lukeovalle/tdse-tpf_1-01/invernadero/invernadero.kicad_pcb

## KiCad design invernadero/invernadero.kicad_pcb (2026-03-22)

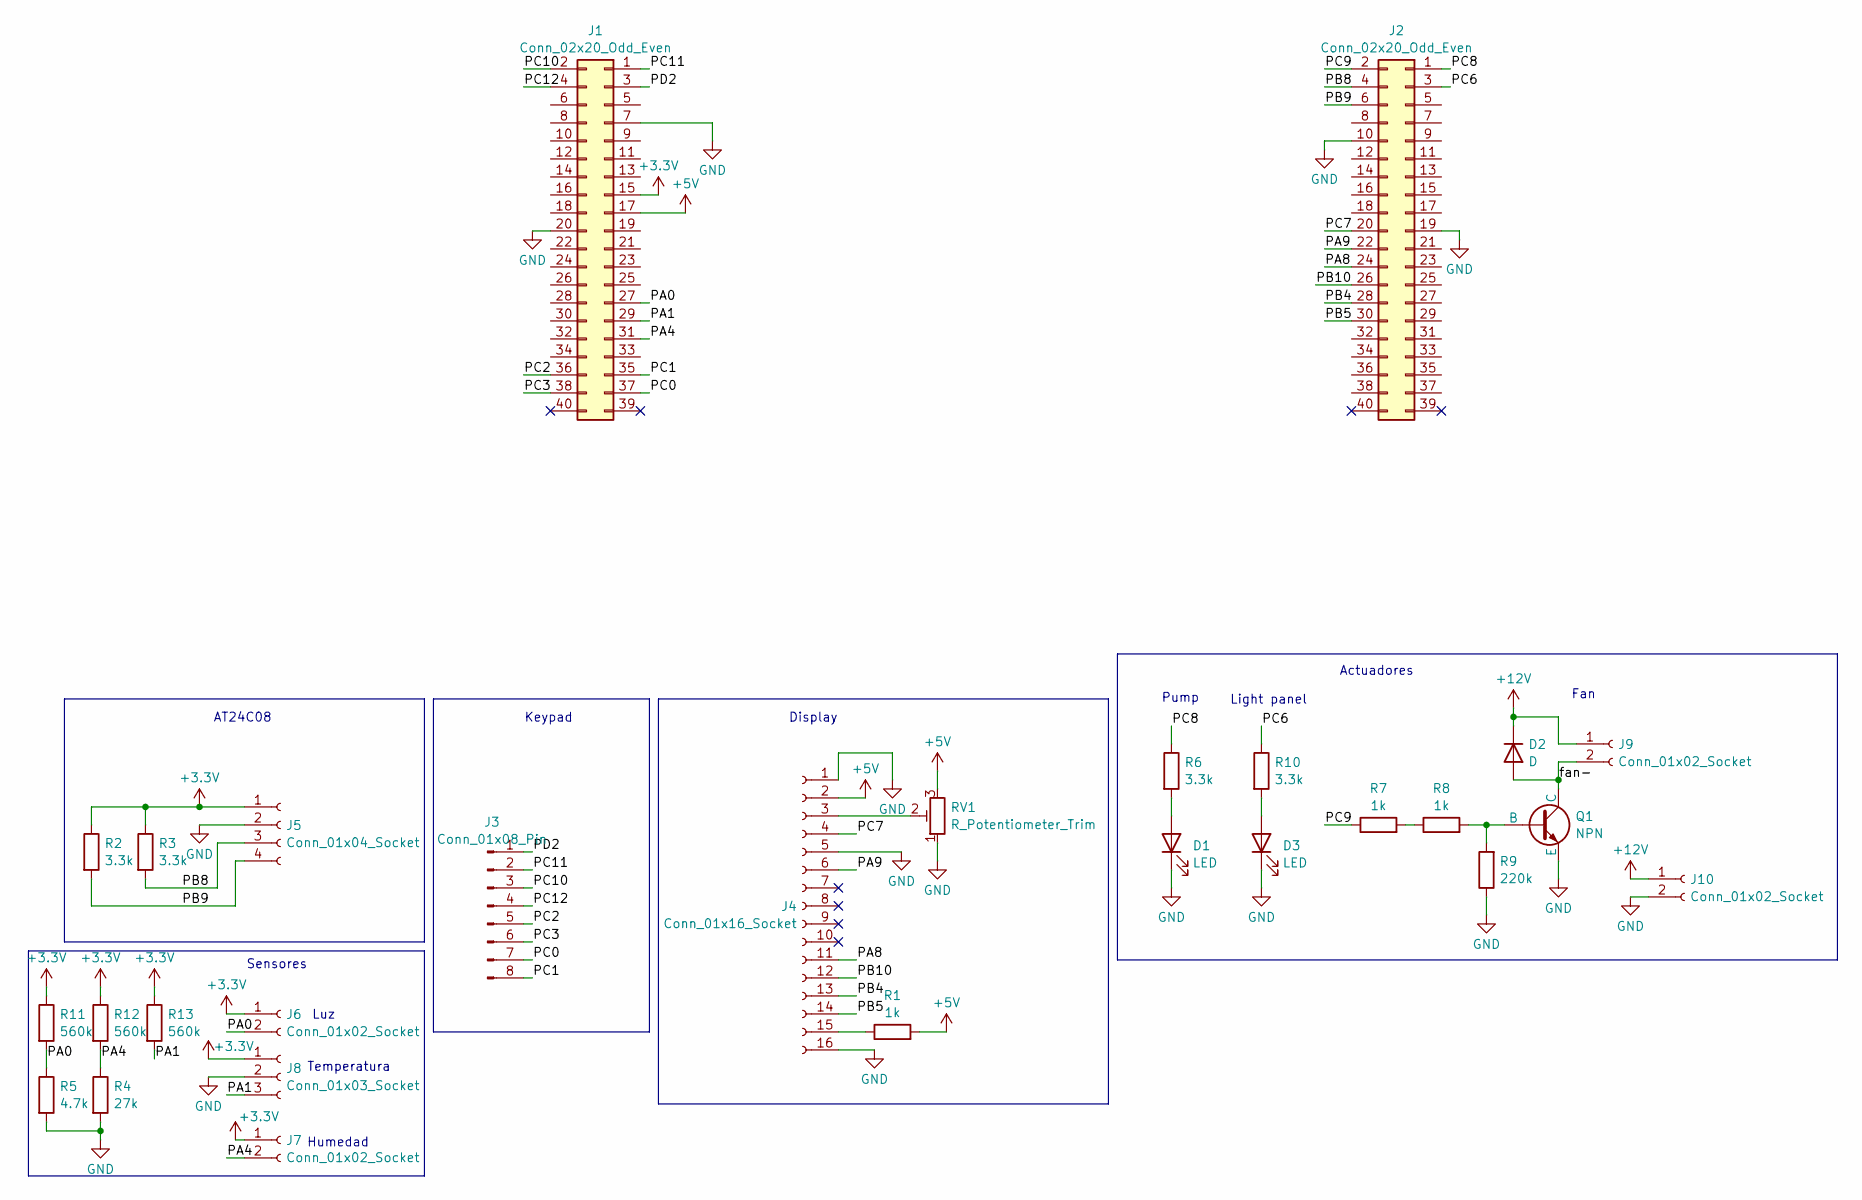
[picture p2: schematic invernadero.kicad_sch]

Parts:
D1, D3: LED; LED_D3.0mm_Clear
D2: D; D_DO-41_SOD81_P7.62mm_Horizontal
J1, J2: Conn_02x20_Odd_Even; PinSocket_2x20_P2.54mm_Vertical
J3: Conn_01x08_Pin; PinHeader_1x08_P2.54mm_Vertical
J4: Conn_01x16_Socket; PinSocket_1x16_P2.54mm_Vertical
J5: Conn_01x04_Socket; PinSocket_1x04_P2.54mm_Vertical
J6, J7: Conn_01x02_Socket; PinSocket_1x02_P2.54mm_Vertical
J8: Conn_01x03_Socket; PinSocket_1x03_P2.54mm_Vertical
J9, J10: Conn_01x02_Socket; TerminalBlock_CUI_TB007-508-02_1x02_P5.08mm_Horizontal
Q1: NPN; TO-92_Inline_Wide
R1, R7, R8: 1k; R_Axial_DIN0204_L3.6mm_D1.6mm_P5.08mm_Horizontal
R2, R3, R6, R10: 3.3k; R_Axial_DIN0204_L3.6mm_D1.6mm_P5.08mm_Horizontal
R4: 27k; R_Axial_DIN0207_L6.3mm_D2.5mm_P7.62mm_Horizontal
R5: 4.7k; R_Axial_DIN0207_L6.3mm_D2.5mm_P7.62mm_Horizontal
R9: 220k; R_Axial_DIN0207_L6.3mm_D2.5mm_P7.62mm_Horizontal
R11, R12, R13: 560k; R_Axial_DIN0207_L6.3mm_D2.5mm_P7.62mm_Horizontal
RV1: R_Potentiometer_Trim; Potentiometer_Bourns_3386P_Vertical

Connections:
+3.3V: J1.15, J5.1, J6.1, J7.1, J8.1, R2.1, R3.1, R11.1, R12.1, R13.1
+5V: J1.17, J4.2, R1.2, RV1.3
+12V: D2.1 (K), J9.1, J10.1
/PA0: J1.27, J6.2, R5.1, R11.2
/PA1: J1.29, J8.3, R13.2
/PA4: J1.31, J7.2, R4.1, R12.2
/PA8: J2.24, J4.11
/PA9: J2.22, J4.6
/PB4: J2.28, J4.13
/PB5: J2.30, J4.14
/PB8: J2.4, J5.3, R3.2
/PB9: J2.6, J5.4, R2.2
/PB10: J2.26, J4.12
/PC0: J1.37, J3.7
/PC1: J1.35, J3.8
/PC2: J1.36, J3.5
/PC3: J1.38, J3.6
/PC6: J2.3, R10.1
/PC7: J2.20, J4.4
/PC8: J2.1, R6.1
/PC9: J2.2, R7.1
/PC10: J1.2, J3.3
/PC11: J1.1, J3.2
/PC12: J1.4, J3.4
/PD2: J1.3, J3.1
/fan-: D2.2 (A), J9.2, Q1.1 (C)
GND: D1.1 (K), D3.1 (K), J1.7, J1.20, J2.10, J2.19, J4.1, J4.5, J4.16, J5.2, J8.2, J10.2, Q1.3 (E), R4.2, R5.2, R9.1, RV1.1
unnamed: D1.2 (A), R6.2
unnamed: D3.2 (A), R10.2
unnamed: J4.3, RV1.2
unnamed: J4.15, R1.1
unnamed: Q1.2 (B), R8.2, R9.2
unnamed: R7.2, R8.1

Notes on the sheet:
Fan
Keypad
Humedad
Display
Temperatura
AT24C08
Luz
Sensores
Actuadores
Light panel
Pump

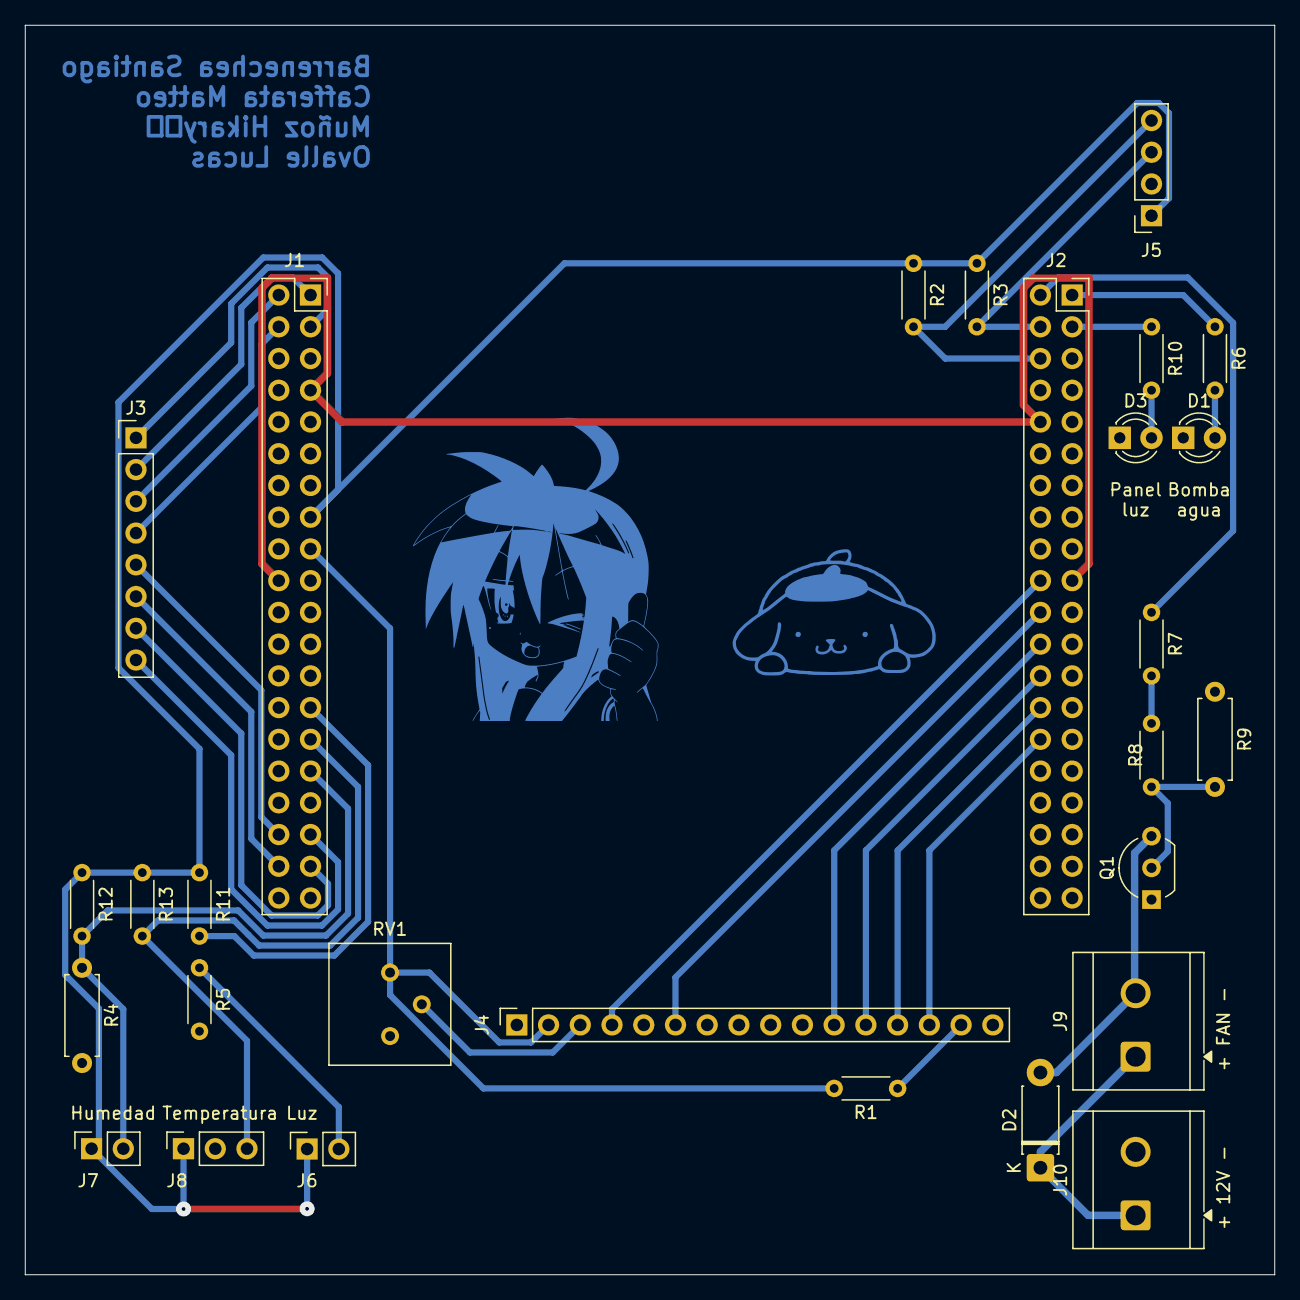
[picture p3: board invernadero.kicad_pcb from above]

Board: 2 copper layers, 100.0 x 100.0 mm, 28 parts (0 on the bottom side), 33 nets.
