lukeovalle/tdse-tpf_1-01/tdse-tpf_1-01.ioc

Mcu.UserName=STM32F103RBTx
PA0-WKUP.GPIO_Label=LIGHT_SENSOR
PA0-WKUP.Signal=ADCx_IN0
PA1.GPIO_Label=TEMP_SENSOR
PA1.Signal=ADCx_IN1
PA13.GPIO_Label=TMS
PA13.Signal=SYS_JTMS-SWDIO
PA14.GPIO_Label=TCK
PA14.Signal=SYS_JTCK-SWCLK
PA2.GPIO_Label=USART_TX
PA2.Signal=USART2_TX
PA3.GPIO_Label=USART_RX
PA3.Signal=USART2_RX
PA4.GPIO_Label=HUMIDITY_SENSOR
PA4.Signal=ADCx_IN4
PA8.GPIO_Label=DISPLAY_D4
PA8.Signal=GPIO_Output
PA9.GPIO_Label=DISPLAY_E
PA9.Signal=GPIO_Output
PB10.GPIO_Label=DISPLAY_D5
PB10.Signal=GPIO_Output
PB3.GPIO_Label=SWO
PB3.Signal=SYS_JTDO-TRACESWO
PB4.GPIO_Label=DISPLAY_D6
PB4.Signal=GPIO_Output
PB5.GPIO_Label=DISPLAY_D7
PB5.Signal=GPIO_Output
PB8.Signal=I2C1_SCL
PB9.Signal=I2C1_SDA
PC0.GPIO_Label=ROW2
PC0.Signal=GPIO_Output
PC1.GPIO_Label=ROW1
PC1.Signal=GPIO_Output
PC10.GPIO_Label=COL2
PC10.Signal=GPIO_Input
PC11.GPIO_Label=COL3
PC11.Signal=GPIO_Input
PC12.GPIO_Label=COL1
PC12.Signal=GPIO_Input
PC14-OSC32_IN.Signal=RCC_OSC32_IN
PC15-OSC32_OUT.Signal=RCC_OSC32_OUT
PC2.GPIO_Label=ROW4
PC2.Signal=GPIO_Output
PC3.GPIO_Label=ROW3
PC3.Signal=GPIO_Output
PC6.GPIO_Label=ACTUATOR_LIGHT_PANEL
PC6.Signal=GPIO_Output
PC7.GPIO_Label=DISPLAY_RS
PC7.Signal=GPIO_Output
PC8.GPIO_Label=ACTUATOR_PUMP
PC8.Signal=GPIO_Output
PC9.GPIO_Label=ACTUATOR_FAN
PC9.Signal=GPIO_Output
PD0-OSC_IN.Signal=RCC_OSC_IN
PD1-OSC_OUT.Signal=RCC_OSC_OUT
PD2.GPIO_Label=COL4
PD2.Signal=GPIO_Input
