lukeovalle/tdse-tpf_1-01/app/src/app.c

/*
 * Copyright (c) 2023 Juan Manuel Cruz <jcruz@fi.uba.ar> <jcruz@frba.utn.edu.ar>.
 * All rights reserved.
 *
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
 * 1. Redistributions of source code must retain the above copyright
 *    notice, this list of conditions and the following disclaimer.
 *
 * 2. Redistributions in binary form must reproduce the above copyright
 *    notice, this list of conditions and the following disclaimer in the
 *    documentation and/or other materials provided with the distribution.
 *
 * 3. Neither the name of the copyright holder nor the names of its
 *    contributors may be used to endorse or promote products derived from
 *    this software without specific prior written permission.
 *
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
 * @file   : app.c
 * @date   : Set 26, 2023
 * @author : Juan Manuel Cruz <jcruz@fi.uba.ar> <jcruz@frba.utn.edu.ar>
 * @version	v1.0.0
 */

/********************** inclusions *******************************************/
/* Project includes */
#include "main.h"

/* Demo includes */
#include "logger.h"
#include "dwt.h"

/* Application & Tasks includes */
#include "app.h"
#include "board.h"
#include "ext_memory.h"
#include "task_actuator.h"
#include "task_clock.h"
#include "task_controller.h"
#include "task_display.h"
#include "task_i2c.h"
#include "task_keypad.h"
#include "task_menu.h"
#include "task_print.h"
#include "task_sensor.h"

/********************** macros and definitions *******************************/
#define G_APP_CNT_INI		0ul
#define G_APP_TICK_CNT_INI	0ul

#define TASK_X_WCET_INI		0ul
#define TASK_X_DELAY_MIN	0ul

typedef struct {
	void (*task_init)(void *);		// Pointer to task (must be a
									// 'void (void *)' function)
	void (*task_update)(void *);	// Pointer to task (must be a
									// 'void (void *)' function)
	void *parameters;				// Pointer to parameters
} task_cfg_t;

typedef struct {
    uint32_t WCET;			// Worst-case execution time (microseconds)
} task_dta_t;

/********************** internal data declaration ****************************/

shared_data_type shared_data;

const task_cfg_t task_cfg_list[]	= {
		{ .task_init = task_actuator_init, .task_update = task_actuator_update, .parameters = &shared_data },
		{ .task_init = task_clock_init, .task_update = task_clock_update, .parameters = &shared_data },
		{ .task_init = task_controller_init, .task_update = task_controller_update, .parameters = &shared_data },
		{ .task_init = task_display_init, .task_update = task_display_update, .parameters = &shared_data },
		{ .task_init = task_i2c_init, .task_update = task_i2c_update, .parameters = &shared_data },
		{ .task_init = task_keypad_init, .task_update = task_keypad_update, .parameters = &shared_data },
		{ .task_init = task_menu_init, .task_update = task_menu_update, .parameters = &shared_data },
		{ .task_init = task_sensor_init, .task_update = task_sensor_update, .parameters = &shared_data }
};

#define TASK_QTY	(sizeof(task_cfg_list)/sizeof(task_cfg_t))

/********************** internal functions declaration ***********************/

/********************** internal data definition *****************************/
const char *p_sys	= " Bare Metal - Event-Triggered Systems (ETS)";
const char *p_app	= " App - Invernaderito";

/********************** external data declaration ****************************/
uint32_t g_app_cnt;
uint32_t g_app_runtime_us;

volatile uint32_t g_app_tick_cnt;

task_dta_t task_dta_list[TASK_QTY];

/********************** external functions definition ************************/
void app_init(void)
{
	uint32_t index;

	/* Print out: Application Initialized */
	LOGGER_INFO(" ");
	LOGGER_INFO("%s is running - Tick [mS] = %lu", GET_NAME(app_init), HAL_GetTick());

	LOGGER_INFO(p_sys);
	LOGGER_INFO(p_app);

	/* Init & Print out: Application execution counter */
	g_app_cnt = G_APP_CNT_INI;
	LOGGER_INFO(" %s = %lu", GET_NAME(g_app_cnt), g_app_cnt);

	/* Init Cycle Counter */
	cycle_counter_init();

    /* Go through the task arrays */
	for (index = 0; TASK_QTY > index; index++)
	{
		/* Run task_x_init */
		(*task_cfg_list[index].task_init)(task_cfg_list[index].parameters);

		/* Init variables */
		task_dta_list[index].WCET = TASK_X_WCET_INI;
	}

	ext_memory_init();

	/* Protect shared resource */
	__asm("CPSID i");	/* disable interrupts */
	/* Init Tick Counter */
	g_app_tick_cnt = G_APP_TICK_CNT_INI;

	g_task_sensor_tick_cnt = G_APP_TICK_CNT_INI;
	g_task_menu_tick_cnt = G_APP_TICK_CNT_INI;
	g_task_print_tick_cnt = G_APP_TICK_CNT_INI;
    __asm("CPSIE i");	/* enable interrupts */
}

void app_update(void)
{
	uint32_t index;
	bool b_time_update_required = false;
	uint32_t cycle_counter_time_us;

	/* Protect shared resource */
	__asm("CPSID i");	/* disable interrupts */
    if (G_APP_TICK_CNT_INI < g_app_tick_cnt)
    {
		/* Update Tick Counter */
    	g_app_tick_cnt--;
    	b_time_update_required = true;
    }
    __asm("CPSIE i");	/* enable interrupts */

	/* Check if it's time to run tasks */
    while (b_time_update_required)
    {
    	/* Update App Counter */
    	g_app_cnt++;
    	g_app_runtime_us = 0;

		/* Go through the task arrays */
		for (index = 0; TASK_QTY > index; index++) {
			uint32_t prev_cycles = DWT->CYCCNT; // tiempo previo a la tarea

    		/* Run task_x_update */
			(*task_cfg_list[index].task_update)(task_cfg_list[index].parameters);

			uint32_t curr_cycles = DWT->CYCCNT; // tiempo después de la tarea

			uint32_t elapsed_cycles = curr_cycles - prev_cycles;

			cycle_counter_time_us = elapsed_cycles  / (SystemCoreClock / 1000000);

			/* Update variables */
			g_app_runtime_us += cycle_counter_time_us;

			if (task_dta_list[index].WCET < cycle_counter_time_us) {
				task_dta_list[index].WCET = cycle_counter_time_us;
			}
		}

		/* Protect shared resource */
		__asm("CPSID i");	/* disable interrupts */
		if (G_APP_TICK_CNT_INI < g_app_tick_cnt)
		{
			/* Update Tick Counter */
			g_app_tick_cnt--;
			b_time_update_required = true;
		}
		else
		{
			b_time_update_required = false;
		}
		__asm("CPSIE i");	/* enable interrupts */
	}
}

void HAL_SYSTICK_Callback(void)
{
	/* Update Tick Counter */
	g_app_tick_cnt++;
	g_task_actuator_tick_cnt++;
	g_task_clock_tick_cnt++;
	g_task_controller_tick_cnt++;
	g_task_display_tick_cnt++;
	g_task_i2c_tick_cnt++;
	g_task_keypad_tick_cnt++;
	g_task_menu_tick_cnt++;
	g_task_print_tick_cnt++;
	g_task_sensor_tick_cnt++;
}

/********************** end of file ******************************************/
