lukeovalle/tdse-tpf_1-01/app/inc/task_menu_attribute.h

/*
 * Copyright (c) 2023 Juan Manuel Cruz <jcruz@fi.uba.ar> <jcruz@frba.utn.edu.ar>.
 * All rights reserved.
 *
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
 * 1. Redistributions of source code must retain the above copyright
 *    notice, this list of conditions and the following disclaimer.
 *
 * 2. Redistributions in binary form must reproduce the above copyright
 *    notice, this list of conditions and the following disclaimer in the
 *    documentation and/or other materials provided with the distribution.
 *
 * 3. Neither the name of the copyright holder nor the names of its
 *    contributors may be used to endorse or promote products derived from
 *    this software without specific prior written permission.
 *
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
 * @file   : task_menu_attribute.h
 * @date   : Set 26, 2023
 * @author : Juan Manuel Cruz <jcruz@fi.uba.ar> <jcruz@frba.utn.edu.ar>
 * @version	v1.0.0
 */

#ifndef TASK_INC_TASK_MENU_ATTRIBUTE_H_
#define TASK_INC_TASK_MENU_ATTRIBUTE_H_

/********************** CPP guard ********************************************/
#ifdef __cplusplus
extern "C" {
#endif

/********************** inclusions *******************************************/
#include "display.h"
#include "task_keypad.h"
#include <stdbool.h>

/********************** macros ***********************************************/

/********************** typedef **********************************************/
/* Menu Statechart - State Transition Table */
/* 	------------------------+-----------------------+-----------------------+-----------------------+--------------------------------------------------------------------------
 * 	| Current               | Event                 |                       						| Next                  |                       							|
 * 	| State                 | (Parameters)          | [Guard]               						| State                 | Actions              								|
 * 	|=======================+=======================+=======================+=======================+=======================|====================================================
 * 	| ST_INIT				| EV_PRESS_HASH/ASTK													| ST_INIT				| Seleccionar configuración o lectura				|
	| ST_INIT				| EV_PRESS_NEXT			| seleccionado configuracion					| ST_CONFIG				|													|
	| ST_INIT				| EV_PRESS_NEXT			| seleccionado lectura y Fecha valida guardada	| ST_READ				|
	| ST_CONFIG				| EV_PRESS_HASH/ASTK	| 												| ST_CONFIG				| Seleccionar tiempo, temperatura, humedad o luz
	| ST_CONFIG				| EV_PRESS_BACK			| 												| ST_INIT				|
	| ST_CONFIG				| EV_PRESS_NEXT			| seleccionado tiempo							| ST_CONFIG_TIME		|
	| ST_CONFIG				| EV_PRESS_NEXT			| seleccionado temperatura						| ST_CONFIG_TEMP		|
	| ST_CONFIG				| EV_PRESS_NEXT			| seleccionado humedad							| ST_CONFIG_HUM			|
	| ST_CONFIG				| EV_PRESS_NEXT			| seleccionado luz								| ST_CONFIG_LIG			|
	| ST_CONFIG_TIME		| EV_PRESS_HASH/ASTK	| 												| ST_CONFIG_TIME		| Cambiar entre dia/fecha/año y hora/minuto
	| ST_CONFIG_TIME		| EV_PRESS_ENTER		| Fecha/Horario introducido valido				| ST_CONFIG_TIME		| Guarda valores ingresados
	| ST_CONFIG_TIME		| EV_PRESS_BACK			| 												| ST_CONFIG				|
	| ST_CONFIG_TEMP		| EV_PRESS_HASH/ASTK	| 												| ST_CONFIG_TEMP		| Cambiar entre maxima y minima
	| ST_CONFIG_TEMP		| EV_PRESS_ENTER		| Temperatura valida							| ST_CONFIG_TEMP		| Guarda valores ingresados
	| ST_CONFIG_TEMP		| EV_PRESS_BACK			|												| ST_CONFIG				|
	| ST_CONFIG_HUM			| EV_PRESS_HASH/ASTK	|												| ST_CONFIG_HUM			| Cambiar entre maxima y minima
	| ST_CONFIG_HUM			| EV_PRESS_ENTER		| Humedad valida								| ST_CONFIG_HUM			| Guarda valores ingresados
	| ST_CONFIG_HUM			| EV_PRESS_BACK			|												| ST_CONFIG				|
	| ST_CONFIG_LIG			| EV_PRESS_HASH/ASTK	|												| ST_CONFIG_LIG			| Cambiar entre maxima y minima
	| ST_CONFIG_LIG			| EV_PRESS_ENTER		| Luminosidad valida							| ST_CONFIG_LIG			| Guarda valores ingresados
	| ST_CONFIG_LIG			| EV_PRESS_BACK			|												| ST_CONFIG				|
	| ST_READ				| EV_PRESS_HASH/ASTK	|												| ST_READ				| Seleccionar tiempo, temperatura, humedad o luz
	| ST_READ				| EV_PRESS_BACK			| 												| ST_INIT				|
	| ST_READ				| EV_PRESS_NEXT			| seleccionado tiempo							| ST_READ_TIME			| Muestra fecha y hora actuales
	| ST_READ				| EV_PRESS_NEXT	 		| seleccionado temperatura						| ST_READ_TEMP			|
	| ST_READ				| EV_PRESS_NEXT			| seleccionado humedad							| ST_READ_HUM			|
	| ST_READ				| EV_PRESS_NEXT			| seleccionado luz								| ST_READ_LIG			|
	| ST_READ_TIME			| EV_PRESS_BACK			|												| ST_READ				|
	| ST_READ_TEMP			| EV_PRESS_HASH/ASTK	|												| ST_READ_TEMP			| Cambiar entre configurada e historicas
	| ST_READ_TEMP			| EV_PRESS_NEXT			| Seleccionada configurada						| ST_READ_TEMP_CON		| Muestra temperaturas maxima y minima
	| ST_READ_TEMP			| EV_PRESS_BACK			|												| ST_READ				|
	| ST_READ_TEMP_CON		| EV_PRESS_BACK			| 												| ST_READ_TEMP			|
	| ST_READ_TEMP			| EV_PRESS_NEXT			| Seleccionada historicas						| ST_READ_TEMP_HIS		| Muestra medición más reciente
	| ST_READ_TEMP_HIS		| EV_PRESS_HASH/ASTK	|												| ST_READ_TEMP_HIS		| Va cambiando las mediciones mostradas
	| ST_READ_TEMP_HIS		| EV_PRESS_BACK			|												| ST_READ_TEMP			|
	| ST_READ_HUM			| EV_PRESS_HASH/ASTK	|												| ST_READ_HUM			| Cambiar entre configurada e historicas
	| ST_READ_HUM			| EV_PRESS_NEXT			| Seleccionada configurada						| ST_READ_HUM_CON		| Muestra humedades maxima y minima
	| ST_READ_HUM_CON		| EV_PRESS_BACK			| 												| ST_READ_HUM			|
	| ST_READ_HUM			| EV_PRESS_NEXT			| Seleccionada historicas						| ST_READ_HUM_HIS		| Muestra medición más reciente
	| ST_READ_HUM_HIS		| EV_PRESS_HASH/ASTK	|												| ST_READ_HUM_HIS		| Va cambiando las mediciones mostradas
	| ST_READ_HUM_HIS		| EV_PRESS_BACK			|												| ST_READ_HUM			|
	| ST_READ_LIG			| EV_PRESS_HASH/ASTK	|												| ST_READ_LIG			| Cambiar entre configurada e historicas
	| ST_READ_LIG			| EV_PRESS_NEXT			| Seleccionada configurada						| ST_READ_LIG_CON		| Muestra luminosidades maxima y minima
	| ST_READ_LIG_CON		| EV_PRESS_BACK			| 												| ST_READ_LIG			|
	| ST_READ_LIG			| EV_PRESS_NEXT			| Seleccionada historicas						| ST_READ_LIG_HIS 		| Muestra medición más reciente
	| ST_READ_LIG_HIS		| EV_PRESS_HASH/ASTK	|												| ST_READ_LIG_HIS		| Va cambiando las mediciones mostradas
	| ST_READ_LIG_HIS		| EV_PRESS_BACK			| 												| ST_READ_LIG			|
 * 	------------------------+-----------------------+-----------------------+-----------------------+------------------------
 */

/* Events to excite Task Menu */
typedef enum task_menu_ev {
	EV_PRESS_NONE,
	EV_PRESS_BACK,
	EV_PRESS_ENTER,
	EV_PRESS_NEXT,
	EV_PRESS_SCROLL,
	EV_PRESS_NUM
} task_menu_ev_t;

/* State of Task Menu */
typedef enum task_menu_st {
	ST_MENU_INIT,
	ST_MENU_CONFIG,
	ST_MENU_CONFIG_TIME,
	ST_MENU_CONFIG_TEMP,
	ST_MENU_CONFIG_HUM,
	ST_MENU_CONFIG_LIG,
	ST_MENU_CONFIG_CLEAR_LOGS,
	ST_MENU_READ,
	ST_MENU_READ_TIME,
	ST_MENU_READ_TEMP_CONF,
	ST_MENU_READ_HUM_CONF,
	ST_MENU_READ_LIG_CONF,
	ST_MENU_READ_HIST_REQUEST,
	ST_MENU_READ_HIST_WAIT,
	ST_MENU_READ_HIST_PRINT,
} task_menu_st_t;

typedef struct
{
	uint32_t		tick;
	task_menu_st_t	state;
	task_menu_st_t	prev_state;
	task_menu_ev_t	event;
	uint32_t		ev_value;
	uint32_t		scroll_idx;
	uint32_t		scroll_max;
	bool			flag;
} task_menu_dta_t;

/********************** external data declaration ****************************/
extern task_menu_dta_t task_menu_dta;

/********************** external functions declaration ***********************/
//Funcion de transformacion de boton presionado a valor numerico y evento correspondientes
void task_menu_push_event(bool btn_pressed, keypad_key_t key);
/********************** End of CPP guard *************************************/
#ifdef __cplusplus
}
#endif

#endif /* TASK_INC_TASK_MENU_ATTRIBUTE_H_ */

/********************** end of file ******************************************/
