lukeovalle/tdse-tpf_1-01/app/inc/keypad.h

#ifndef KEYPAD_H
#define KEYPAD_H

#include <stdint.h>

typedef enum {
	KEY_NONE = 0,
    KEY_1, KEY_2, KEY_3, KEY_A,
    KEY_4, KEY_5, KEY_6, KEY_B,
    KEY_7, KEY_8, KEY_9, KEY_C,
    KEY_STAR, KEY_0, KEY_HASH, KEY_D,
} keypad_key_t;

keypad_key_t keypad_read_key(uint8_t row, uint8_t col);
keypad_key_t keypad_scan(void);

#endif
