lukeovalle/tdse-tpf_1-01/app/src/keypad.c

#include "keypad.h"
#include "display.h"
#include "stm32f1xx_hal.h"
#include "dwt.h"

/* === CONFIGURACION HARDWARE === */
GPIO_TypeDef* ROW_PORT[4] = {GPIOC,			GPIOC,			GPIOC,			GPIOC};
uint16_t ROW_PIN[4]       = {GPIO_PIN_1,	GPIO_PIN_0,		GPIO_PIN_3,		GPIO_PIN_2};

GPIO_TypeDef* COL_PORT[4] = {GPIOC,			GPIOC,			GPIOC,			GPIOD};
uint16_t COL_PIN[4]       = {GPIO_PIN_12,	GPIO_PIN_10,	GPIO_PIN_11,	GPIO_PIN_2};

/* ============================== */

static const keypad_key_t key_map[4][4] = {
    {KEY_1, KEY_2, KEY_3, KEY_A},
    {KEY_4, KEY_5, KEY_6, KEY_B},
    {KEY_7, KEY_8, KEY_9, KEY_C},
    {KEY_STAR, KEY_0, KEY_HASH, KEY_D}
};

static uint8_t current_row = 0;

keypad_key_t keypad_read_key(uint8_t row, uint8_t col) {
	keypad_key_t key;

	HAL_GPIO_WritePin(ROW_PORT[row], ROW_PIN[row], GPIO_PIN_SET);
	if (HAL_GPIO_ReadPin(COL_PORT[col], COL_PIN[col]) == GPIO_PIN_SET) {
		key = key_map[row][col];
	} else
		key = KEY_NONE;

	HAL_GPIO_WritePin(ROW_PORT[row], ROW_PIN[row], GPIO_PIN_RESET);

	return key;
}

keypad_key_t keypad_scan(void)
{
    // Desactivar todas las filas
    for (uint8_t i = 0; i < 4; i++) HAL_GPIO_WritePin(ROW_PORT[i], ROW_PIN[i], GPIO_PIN_SET);

    // Activar la fila actual
    HAL_GPIO_WritePin(ROW_PORT[current_row], ROW_PIN[current_row], GPIO_PIN_RESET);

    for (uint8_t col = 0; col < 4; col++)
        if (HAL_GPIO_ReadPin(COL_PORT[col], COL_PIN[col]) == GPIO_PIN_RESET)
            return key_map[current_row][col];

    current_row = (current_row + 1) & 0x03;
    
    /*         
    for (uint8_t row = 0; row < 4; row++)
    {
        HAL_GPIO_WritePin(ROW_PORT[row], ROW_PIN[row], GPIO_PIN_RESET);
        //display_delay_us(5);
        // Si no anda sin el delay usar 1 o 2 : __NOP();
        // definiendo #define KEYPAD_STABILIZATION() __NOP(); __NOP()
        // KEYPAD_STABILIZATION();

        for (uint8_t col = 0; col < 4; col++)
            if (HAL_GPIO_ReadPin(COL_PORT[col], COL_PIN[col]) == GPIO_PIN_SET)
                return key_map[row][col];

        HAL_GPIO_WritePin(ROW_PORT[row], ROW_PIN[row], GPIO_PIN_RESET);
    }
    */

    return KEY_NONE;
}
