lukeovalle/tdse-tpf_1-01/app/inc/task_clock.h

/*
 * task_clock.h
 *
 *  Created on: Jan 30, 2026
 *      Author: luke
 */

#ifndef INC_TASK_CLOCK_H_
#define INC_TASK_CLOCK_H_

/********************** CPP guard ********************************************/
#ifdef __cplusplus
extern "C" {
#endif


/********************** inclusions *******************************************/

/********************** macros ***********************************************/

/********************** typedef **********************************************/
typedef enum {
	JANUARY = 0,
	FEBRUARY,
	MARCH,
	APRIL,
	MAY,
	JUNE,
	JULY,
	AUGUST,
	SEPTEMBER,
	OCTOBER,
	NOVEMBER,
	DECEMBER
} month_t;

typedef struct {
	uint16_t	year;
	month_t		month;
	uint8_t		day;
	uint8_t		hours, minutes, seconds;
} date_time_t;

/********************** external data declaration ****************************/
extern uint32_t g_task_clock_cnt;
extern volatile uint32_t g_task_clock_tick_cnt;

/********************** external functions declaration ***********************/
extern void task_clock_init(void *parameters);
extern void task_clock_update(void *parameters);

void clock_config_set_year(uint16_t year);
void clock_config_set_month(month_t month);
void clock_config_set_day(uint8_t day);
void clock_config_set_hour(uint8_t hour);
void clock_config_set_minute(uint8_t minute);
date_time_t clock_get_time(void);

date_time_t timestamp_to_datetime(uint32_t timestamp);
uint32_t	datetime_to_timestamp(date_time_t * date);


/********************** End of CPP guard *************************************/
#ifdef __cplusplus
}
#endif

#endif /* INC_TASK_CLOCK_H_ */
