lukeovalle/tdse-tpf_1-01/(commit log)

2025-09-14 inicio proyecto stm32
2025-09-14 inicio circuito kicad
    [invernadero.kicad_pcb, invernadero.kicad_sch]
2025-10-03 light sensor started. i2c and adc pins assigned
2025-10-15 Implementación del sensor de luz, falta leer el ADC
2025-10-31 definición de función de lectura de sensor de luz
    [tdse-tpf_1-01 Debug.cfg]
2025-11-07 sensor de luz funciona, iniciado sensor de humedad
2025-11-12 Unificación de lógica de los sensores, medición de ADC
2025-11-19 Rangos de sensores modificados. Eliminado módulo de humedad.
2025-11-28 Lectura correcta de sensores
    [tdse-tpf_1-01 Debug.cfg]
2025-12-10 Módulo I2C iniciado.
2025-12-16 I2C Compila.
2026-01-21 I2C: función para escribir una página en memoria y cambios en la máquina de estados
2026-01-22 I2C: Módulo terminado
2026-01-22 Definición de interfaz de memoria
2026-01-24 Implementadas funciones de manejo de memoria externa
2026-01-26 buffer circular para escribir a memoria externa. funciones auxiliares de memoria escriben al buffer
2026-01-27 task I2C usa el buffer de escritura y definida interfaz de lectura para I2C
2026-01-27 Errores arreglados en I2C y memoria
    [app.c, ext_memory.c, task_i2c.c, task_print.c, task_print.h]
2026-01-28 Arreglados problemas de dirección de memoria y de dispositivo en I2C
    [ext_memory.c, ext_memory.h, task_i2c.c, task_i2c.h]
2026-01-28 Debugging de lectura/escritura de memoria
2026-01-30 Arreglado error en la máquina de estados y callbacks correctos
    [task_i2c.c, task_print.c]
2026-01-30 I2C FUNCIONA
2026-01-30 Removida tarea de prueba y loggers, memoria eeprom empieza en 0x00
2026-01-30 Iniciada tarea de clock
2026-01-30 Maquina de estados esquematica
2026-01-31 máquina de estados de clock implementada
2026-01-31 WCET cambiado para no reiniciar el contador de ciclos. Reloj funciona.
2026-01-31 funciones vacías de configuración de fecha y hora
2026-01-31 código copiado de la rama botonera
2026-01-31 cambiados pines de conexión de display y botonera
2026-02-03 funciones para configurar fecha y hora
2026-02-03 Validación de memoria externa llena
2026-02-03 placa con conexiones para display y botonera
    [invernadero.kicad_pcb, invernadero.kicad_sch]
2026-02-04 Diseño de PCB completo
    [invernadero.kicad_pcb, invernadero.kicad_sch]
2026-02-04 esquemático
    [invernadero.kicad_sch]
2026-02-04 maquina de estados 10%
2026-02-04 maquina de estados 20%
2026-02-04 maquina de estados 40%
2026-02-04 maquina de estados 50%
2026-02-04 maquina de estados 60%
2026-02-05 copiados cambios de rama botonera
2026-02-05 Máquina de estados de actuadores. Añadidos pines en archivo ioc.
2026-02-05 Empezar lectura de botones
2026-02-06 Lectura de botones
2026-02-06 Lectura de botones completa (espero)
2026-02-06 Funciones de conversión entre timestamp y date_time_t
2026-02-06 Bug corregido en conversión entre timestamp y datetime
    [task_clock.c, task_print.c]
2026-02-07 Logica de scroll implementada
2026-02-09 Arregladas funciones de conversión entre timestamp y date_time
    [task_clock.c]
2026-02-09 cambios en el pcb
    [invernadero.kicad_pcb, invernadero.kicad_sch]
2026-02-09 Velocidad de clock aumentada a 20 MHz, flag en mem_buffer agregado
2026-02-09 append_to_buffer para lectura y escritura
2026-02-09 ignorar configuraciones del ide y archivos temporales de kicad en el repo
2026-02-10 Terminado de implementar buffer para lectura
2026-02-10 Solucionados algunos bugs de lectura y escritura en memoria. macros MIN y MAX
    [ext_memory.c, memory_buffer.c, task_print.c, utils.h]
2026-02-10 Modificado footprint de led y path de fan más ancho
    [invernadero.kicad_pcb, invernadero.kicad_sch]
2026-02-10 path del fan más ancho
2026-02-11 Lógica del controlador implementada. Añadido panel de luz. Configuración guarda horas diarias de luz, valor mínimo de luz y temperaturas por día/noche. PCB actualizado.
    [invernadero.kicad_pcb, invernadero.kicad_sch]
2026-02-19 Solucionado error de concurrencia en sensores. Sensores miden resistencia
    [main.c, task_controller.c, task_print.c, task_sensor.c, task_sensor_attribute.h, tdse-tpf_1-01.ioc]
2026-02-19 PCB reordenado. Pistas ensanchadas.
    [invernadero.kicad_pcb, invernadero.kicad_sch]
2026-02-19 Cálculo de porcentaje de humedad y cálculo de temperatura
2026-02-21 Medición de humedad.
2026-02-24 sensor de luz calibrado
2026-02-27 Correcciones: pines keypad y display; errores de copilación
    [display.c, display.h, keypad.c, num_buffer.h, task_keypad.c, task_keypad.h, task_menu.c, task_menu_attribute.c]
2026-02-27 tareas de menu y keypad agregadas
2026-02-28 Emprolijado de mensajes por menu_display
2026-02-28 Corrección de displays para números
2026-03-02 Corregido bug en nombre de función
    [task_menu_display.c, task_menu_display.h]
2026-03-02 Display muestras (falta el tema del tiempo de la muestra)
2026-03-02 pantalla inicial se muestra correctamente
    [task_menu_display.c]
2026-03-02 Menú lee y escribe correctamente las configuraciones
    [display.c, task_controller.c, task_controller.h, task_menu.c, task_menu_attribute.h, task_menu_display.c]
2026-03-03 Máquina de estados del menú espera a que se lean los datos de memoria
2026-03-03 Menús reordenados, agregada opción de limpiar logs
2026-03-03 Velocidad de reloj aumentada a 72MHz. Solucionado problema de desbordamiento de reloj.
    [display.c, main.c, task_clock.c, task_controller.c, task_menu.c, task_menu_attribute.h, task_menu_display.c, tdse-tpf_1-01.ioc]
2026-03-10 Máquina de estados para display. keypad con tick counter
2026-03-11 Solucionados errores y warnings
    [logger.h, task_display.c, task_display_attribute.h, task_menu_display.c]
2026-03-22 Correcciones de Santaigo
2026-03-22 PCB actualizado
    [invernadero.kicad_pcb, invernadero.kicad_sch]
2026-03-22 PCB actualizado 2
    [invernadero.kicad_pcb]
2026-03-22 PCB actualizado 3
    [invernadero.kicad_sch]
2026-03-23 Keypad escanea de a una tecla por iteración
2026-03-24 Display imprime correctamente la segunda línea. Tiempos de ejecución reducidos
    [display.c, display.h, task_display.c, task_i2c.c, task_menu.c, task_menu_display.c, task_menu_interface.c]
2026-03-24 Resistencia máxima en los sensores
2026-03-24 Velocidad de reloj y systick modificados
2026-03-27 Solucionadas impresiones de texto
2026-03-27 Solucionado problema de pantalla. Funciona todo
    [num_buffer.h, task_controller.c, task_menu.c, task_menu_display.c]
